jagathsrujan/3d-printable-planetary-gearbox/assets/raw/3D-Model-of-a-two-stage-planetary-gearbox-with-16-to-1-ratio-1024x576.jpg

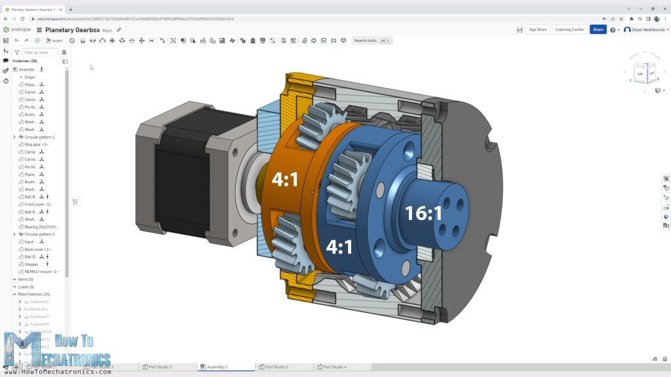
assets/raw/3D-Model-of-a-two-stage-planetary-gearbox-with-16-to-1-ratio-1024x576.jpg
