jagathsrujan/3d-printable-planetary-gearbox/assets/raw/15-teeth-gears-with-3-different-modules-comparison-1024x576.jpg

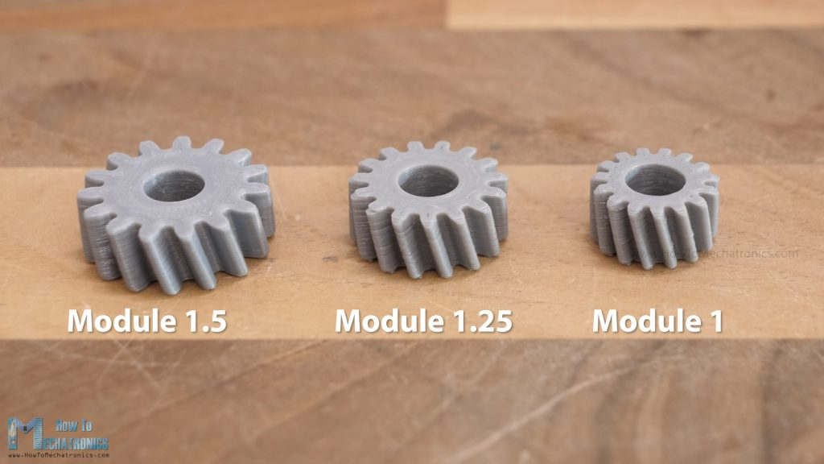
assets/raw/15-teeth-gears-with-3-different-modules-comparison-1024x576.jpg
