jagathsrujan/3d-printable-planetary-gearbox/assets/raw/Co-prime-numbers-for-gears-teeth-1024x576.jpg

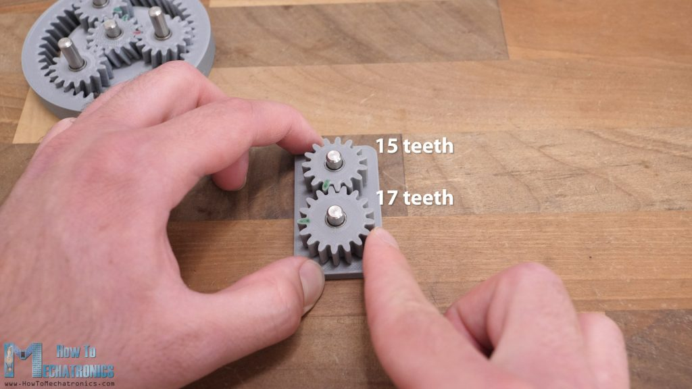
assets/raw/Co-prime-numbers-for-gears-teeth-1024x576.jpg
