jagathsrujan/3d-printable-planetary-gearbox/assets/raw/Design-rule-for-planetary-gearbox-1024x576.jpg

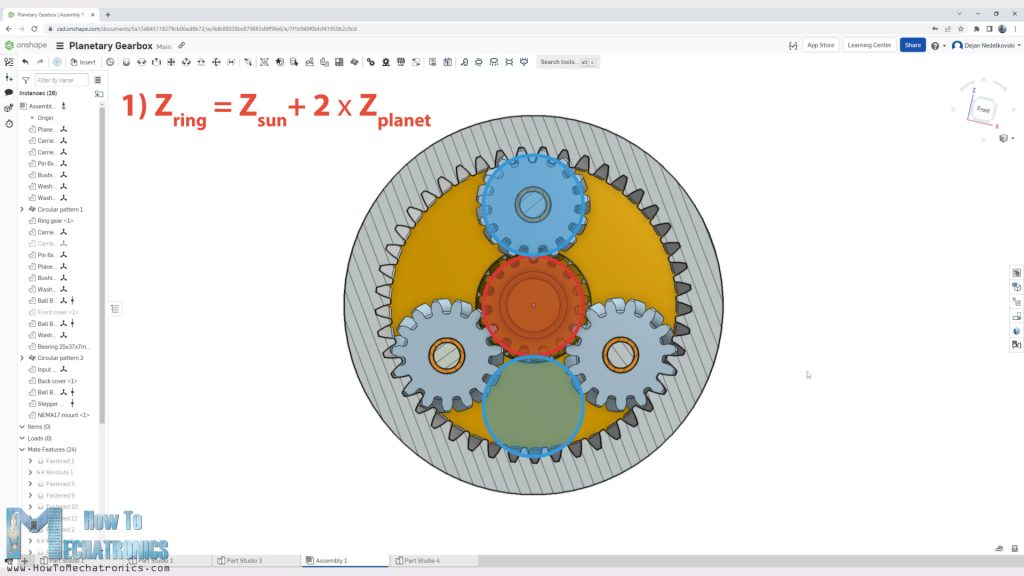
assets/raw/Design-rule-for-planetary-gearbox-1024x576.jpg
