jagathsrujan/3d-printable-planetary-gearbox/assets/raw/Forces-in-planetary-gearboxes-1024x576.jpg

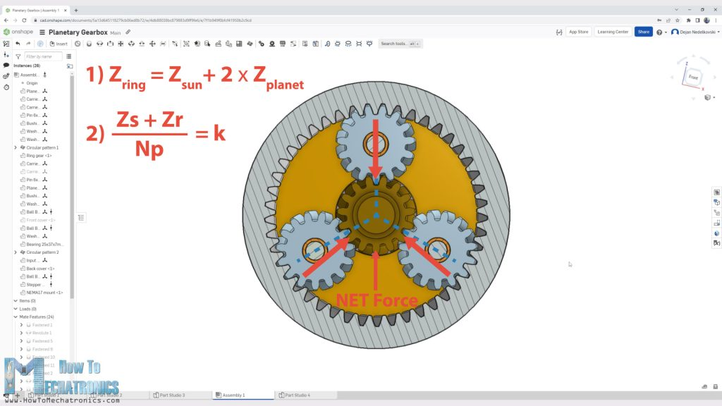
assets/raw/Forces-in-planetary-gearboxes-1024x576.jpg
