jagathsrujan/3d-printable-planetary-gearbox/assets/raw/Generating-a-gear-in-Onshape-with-the-Spur-Gear-FeatureScript-1024x576.jpg

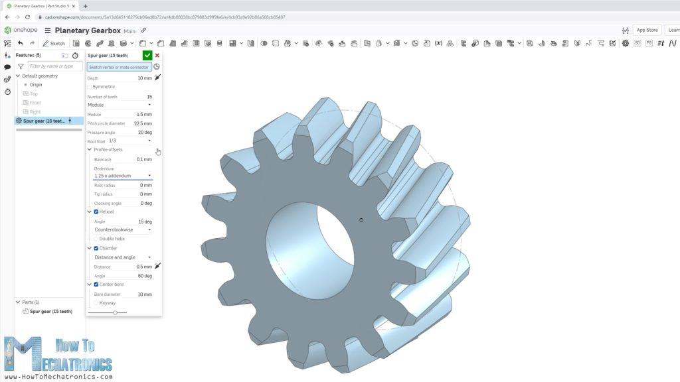
assets/raw/Generating-a-gear-in-Onshape-with-the-Spur-Gear-FeatureScript-1024x576.jpg
