jagathsrujan/3d-printable-planetary-gearbox/assets/raw/Generating-a-gear-with-internal-teeth-ring-gear-in-Onshape-with-the-Boolean-function-1024x576.jpg

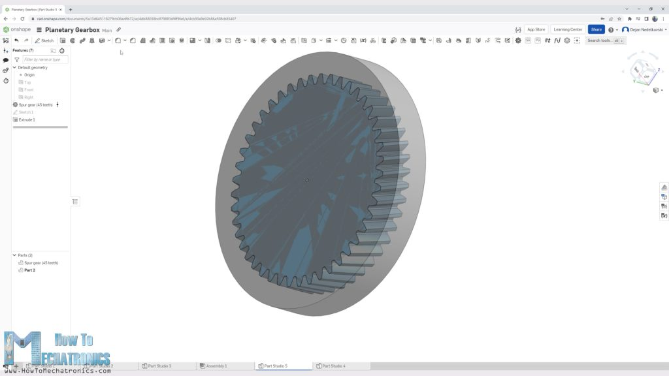
assets/raw/Generating-a-gear-with-internal-teeth-ring-gear-in-Onshape-with-the-Boolean-function-1024x576.jpg
