jagathsrujan/3d-printable-planetary-gearbox/assets/raw/Grub-screw-for-securing-the-motor-shaft-to-the-gearbox-input-shaft-1024x576.jpg

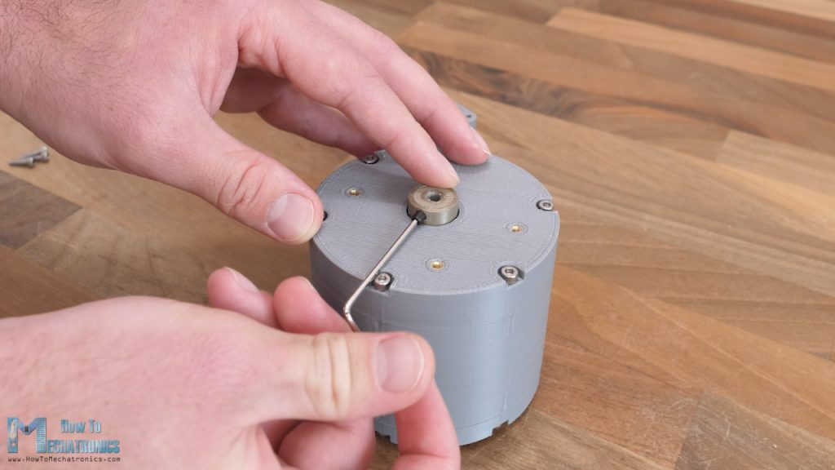
assets/raw/Grub-screw-for-securing-the-motor-shaft-to-the-gearbox-input-shaft-1024x576.jpg
