jagathsrujan/3d-printable-planetary-gearbox/assets/raw/How-a-Planetary-Gear-Set-Works-1024x671.jpg

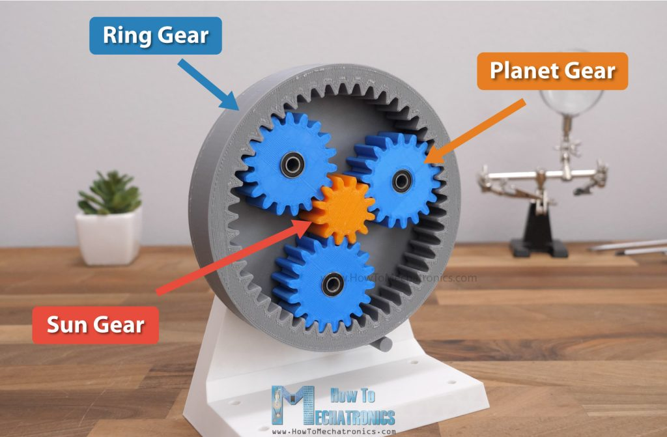
assets/raw/How-a-Planetary-Gear-Set-Works-1024x671.jpg
