jagathsrujan/3d-printable-planetary-gearbox/assets/raw/Inserting-a-threaded-insert-1024x576.jpg

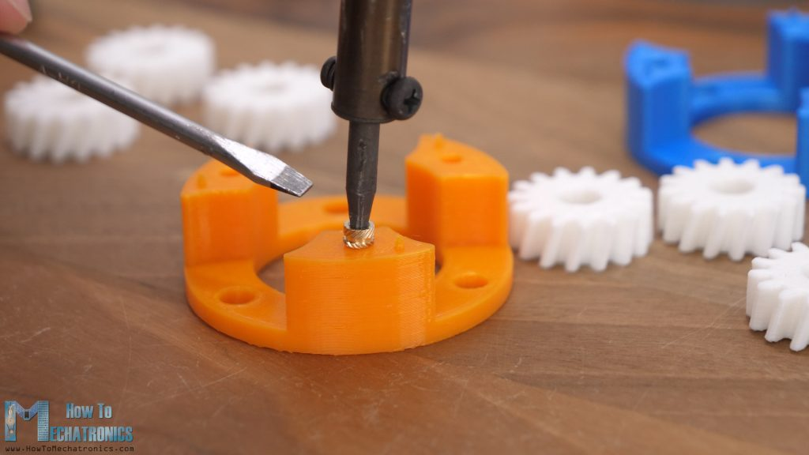
assets/raw/Inserting-a-threaded-insert-1024x576.jpg
