jagathsrujan/3d-printable-planetary-gearbox/assets/raw/Measuring-the-backlash-with-specific-amount-load-applied-to-the-output-shaft-1024x576.jpg

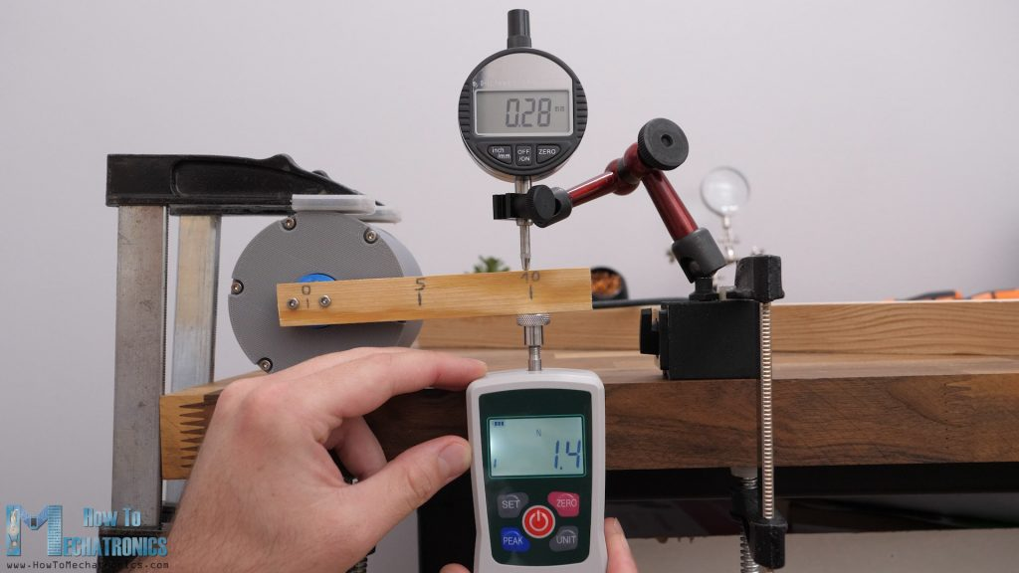
assets/raw/Measuring-the-backlash-with-specific-amount-load-applied-to-the-output-shaft-1024x576.jpg
