jagathsrujan/3d-printable-planetary-gearbox/assets/raw/Modeling-the-ring-gear-as-a-housing-for-the-gearbox-1024x576.jpg

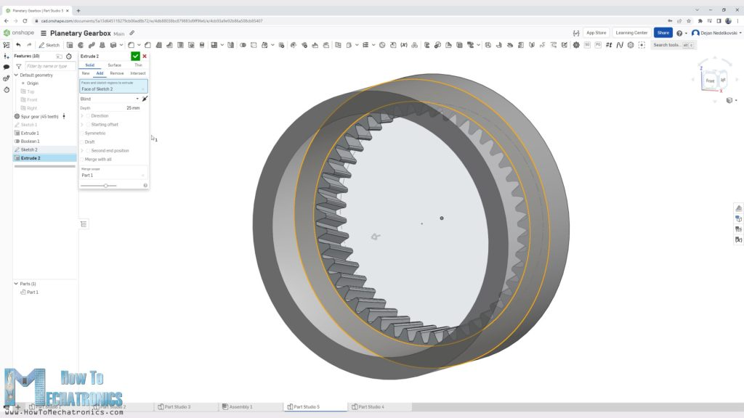
assets/raw/Modeling-the-ring-gear-as-a-housing-for-the-gearbox-1024x576.jpg
