jagathsrujan/3d-printable-planetary-gearbox/assets/raw/Planetary-gear-set-first-stage-1024x576.jpg

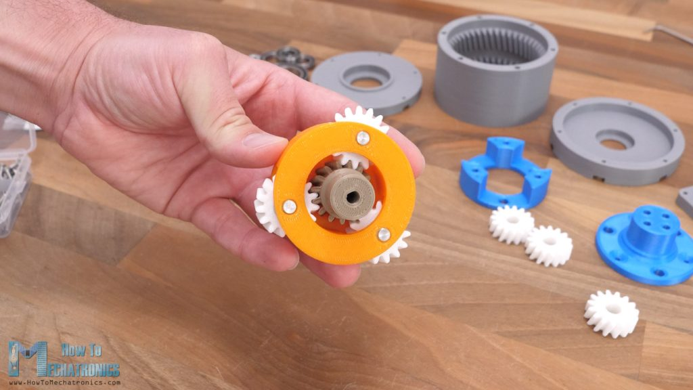
assets/raw/Planetary-gear-set-first-stage-1024x576.jpg
