jagathsrujan/3d-printable-planetary-gearbox/assets/raw/Planetary-gear-set-Sun-gear-input-and-ring-gear-output-example-1024x576.jpg

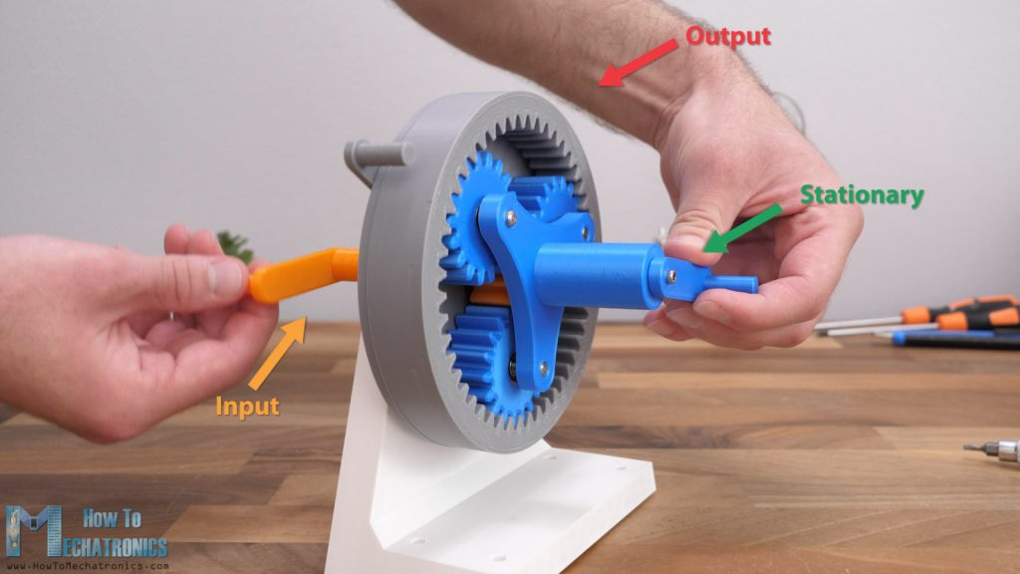
assets/raw/Planetary-gear-set-Sun-gear-input-and-ring-gear-output-example-1024x576.jpg
