jagathsrujan/3d-printable-planetary-gearbox/assets/raw/Planetary-gearbox-Ring-gear-as-input-and-carrier-as-output-1024x576.jpg

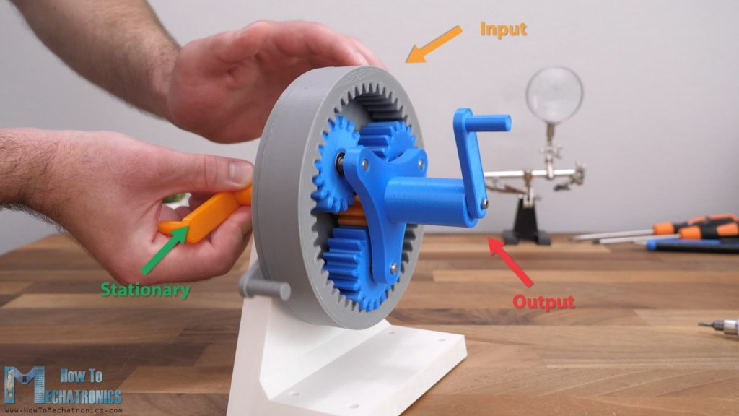
assets/raw/Planetary-gearbox-Ring-gear-as-input-and-carrier-as-output-1024x576.jpg
