jagathsrujan/3d-printable-planetary-gearbox/assets/raw/Planetary-gearbox-working-principle--1024x576.jpg

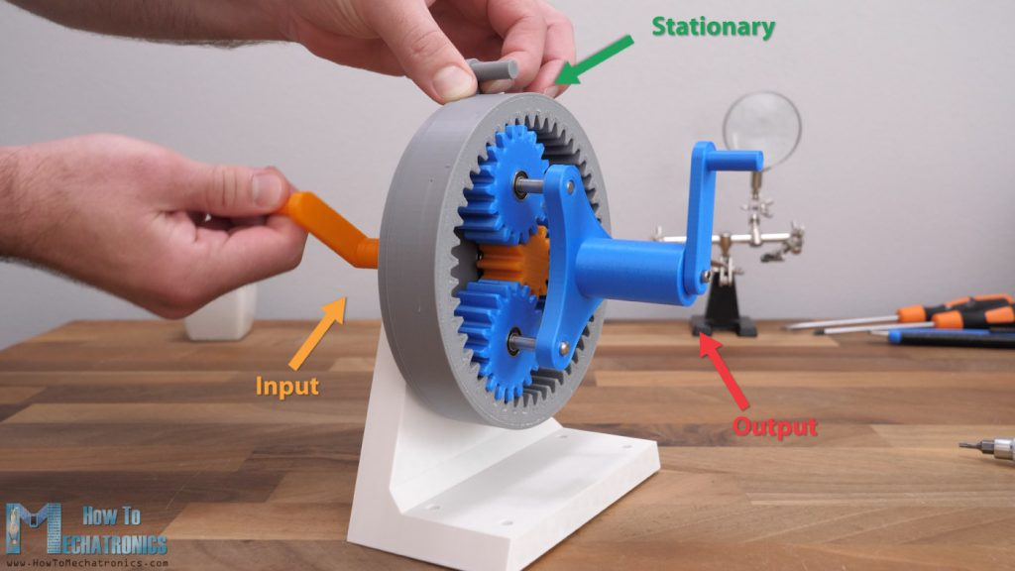
assets/raw/Planetary-gearbox-working-principle--1024x576.jpg
