jagathsrujan/3d-printable-planetary-gearbox/assets/raw/Planetary-gears-in-automatic-transmissions-1024x623.jpg

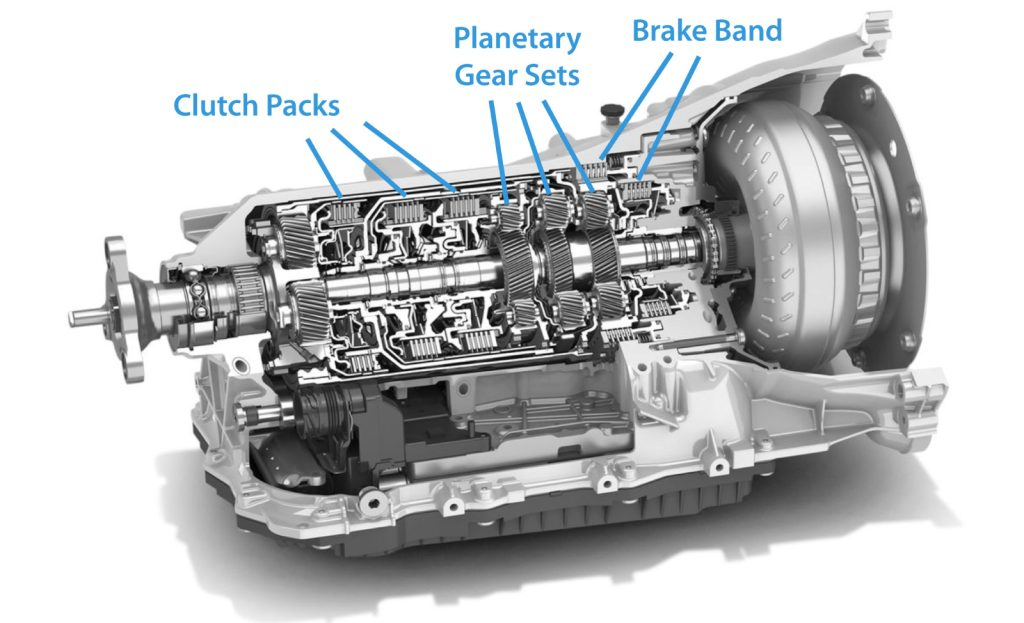
assets/raw/Planetary-gears-in-automatic-transmissions-1024x623.jpg
