jagathsrujan/3d-printable-planetary-gearbox/assets/raw/Planetary-gears-transmission-ratios-formulas-with-example.jpg

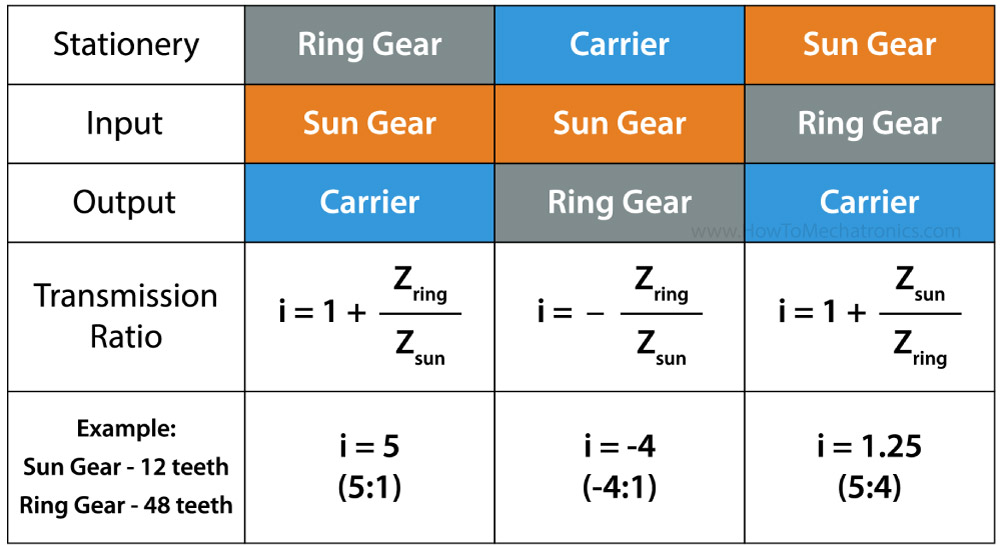
assets/raw/Planetary-gears-transmission-ratios-formulas-with-example.jpg
