jagathsrujan/3d-printable-planetary-gearbox/assets/raw/Sun-gear-and-planet-carrier-design-in-Onshape-1024x576.jpg

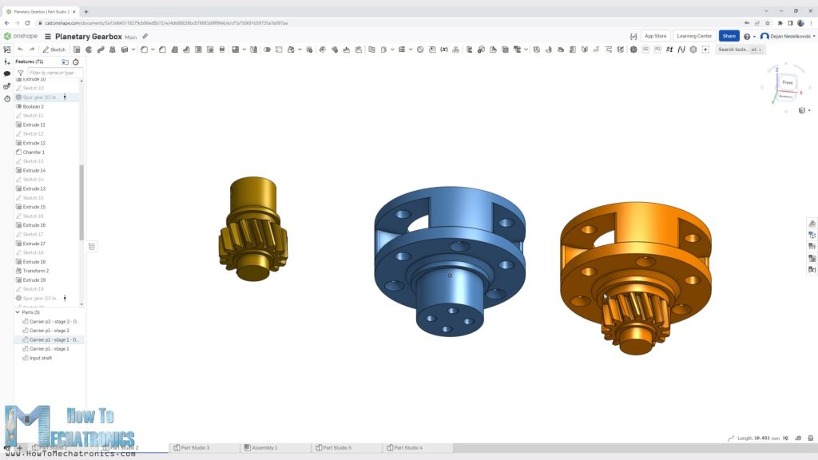
assets/raw/Sun-gear-and-planet-carrier-design-in-Onshape-1024x576.jpg
