jagathsrujan/3d-printable-planetary-gearbox/assets/raw/Two-stage-planetary-gearbox-3D-Model-in-Onshape-1024x558.jpg

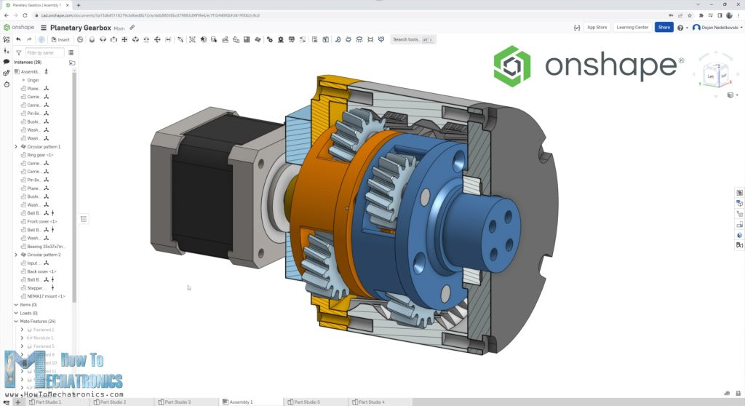
assets/raw/Two-stage-planetary-gearbox-3D-Model-in-Onshape-1024x558.jpg
