jagathsrujan/3d-printable-planetary-gearbox/assets/raw/Two-stage-planetary-gearbox-design-1024x576.jpg

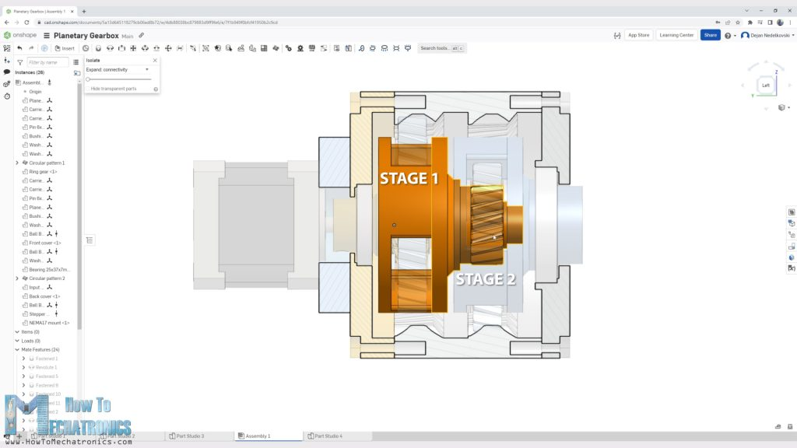
assets/raw/Two-stage-planetary-gearbox-design-1024x576.jpg
