jagathsrujan/3d-printable-planetary-gearbox/assets/raw/Two-stage-planetary-gearbox-with-16-to-1-reduction-ratio-1024x576.jpg

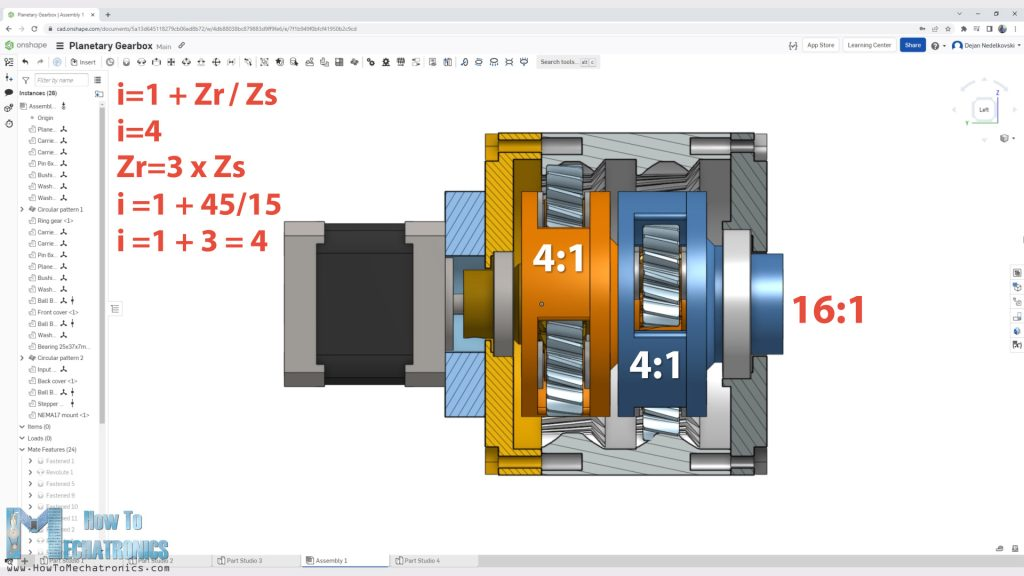
assets/raw/Two-stage-planetary-gearbox-with-16-to-1-reduction-ratio-1024x576.jpg
