jagathsrujan/3d-printable-planetary-gearbox/assets/raw/Uneven-wear-of-the-gears-if-they-have-the-same-number-of-teeth-1024x576.jpg

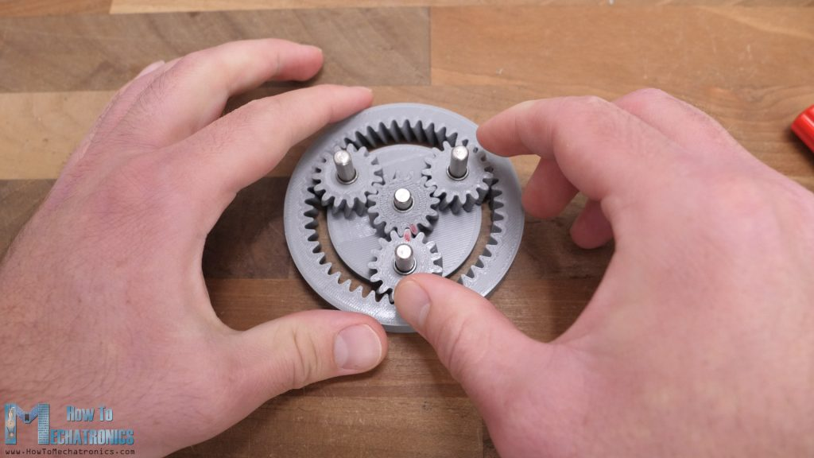
assets/raw/Uneven-wear-of-the-gears-if-they-have-the-same-number-of-teeth-1024x576.jpg
