jagathsrujan/3d-printable-planetary-gearbox/assets/renders/stage-cutaway-alt.png

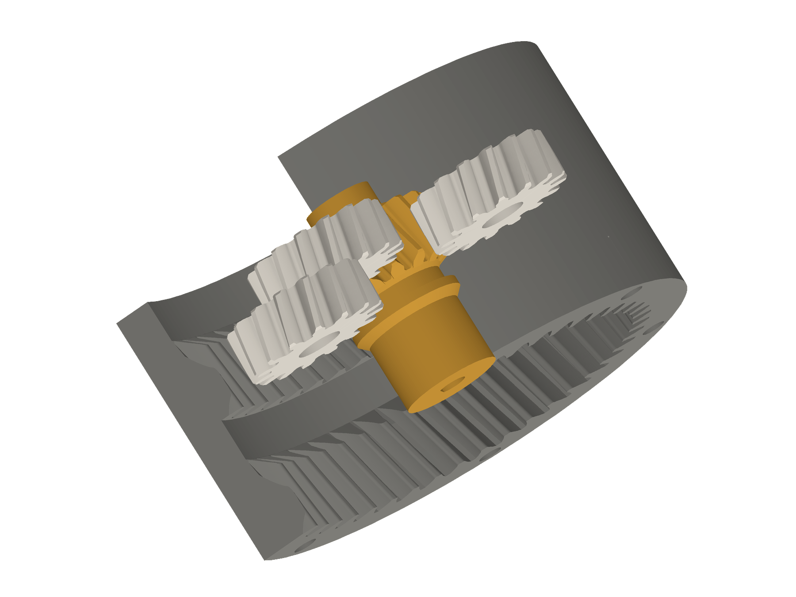
assets/renders/stage-cutaway-alt.png
