jagathsrujan/3d-printable-planetary-gearbox/assets/raw/3D-Printed-parts-for-two-stage-planetary-gearbox-1024x576.jpg

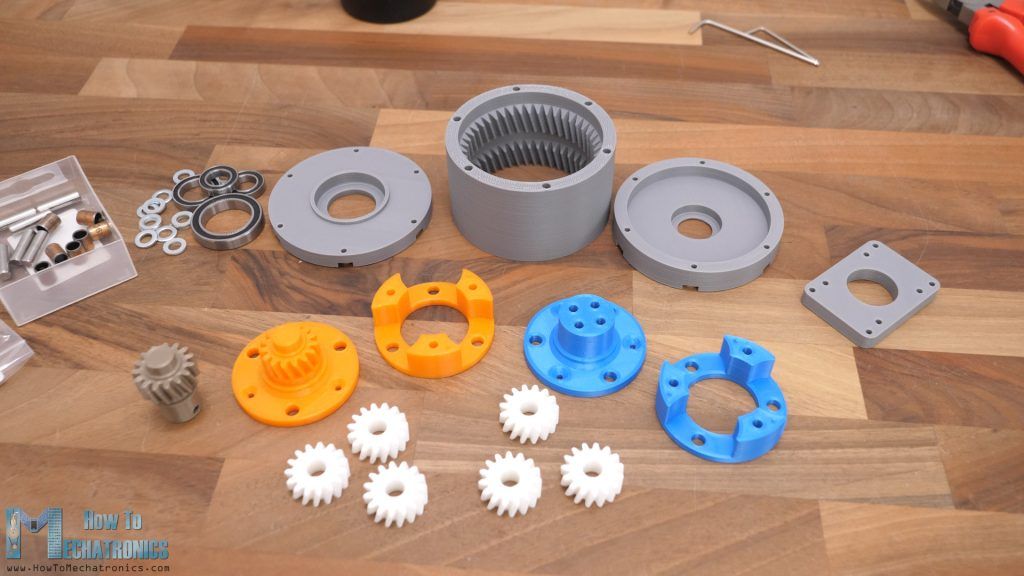
assets/raw/3D-Printed-parts-for-two-stage-planetary-gearbox-1024x576.jpg
