jagathsrujan/3d-printable-planetary-gearbox/assets/raw/Planetary-gearbox-cutaway-section-view-of-the-internal-parts-1024x576.jpg

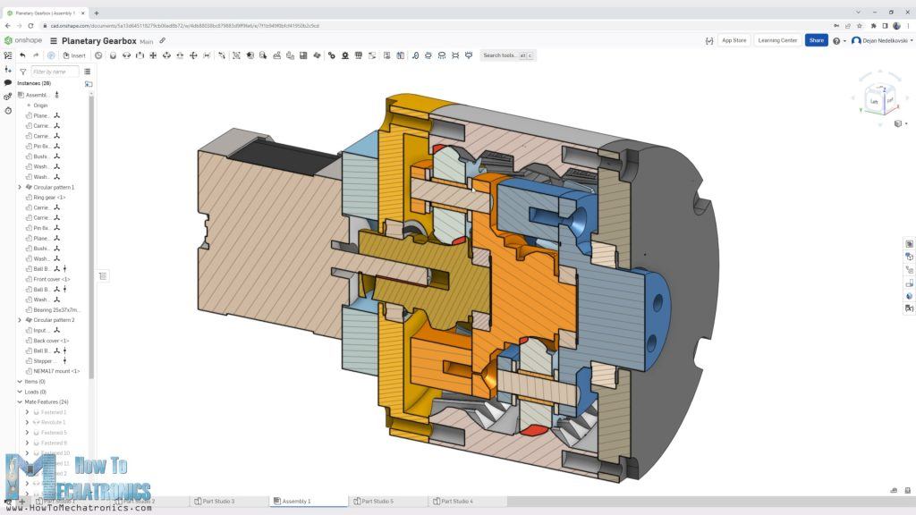
assets/raw/Planetary-gearbox-cutaway-section-view-of-the-internal-parts-1024x576.jpg
