jagathsrujan/3d-printable-planetary-gearbox/assets/raw/Using-the-transform-function-in-Onshape-for-copying-parts-1024x576.jpg

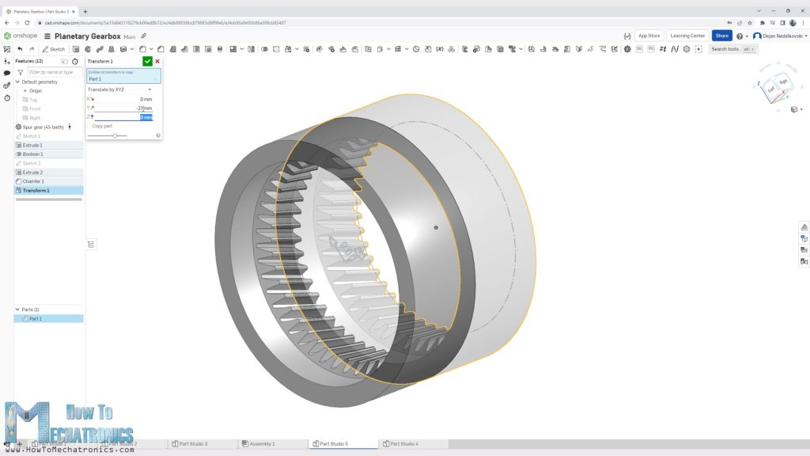
assets/raw/Using-the-transform-function-in-Onshape-for-copying-parts-1024x576.jpg
