jagathsrujan/3d-printable-planetary-gearbox/cad/encoder_mount_assembly.step

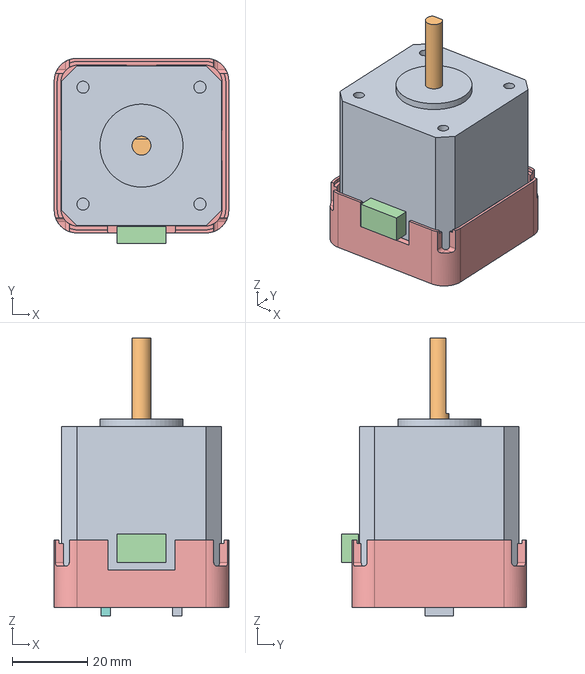
[picture p29: CAD file, 2026-10-26]
cad/encoder_mount_assembly.step
46.3 x 49.1 x 73.7 mm
