jagathsrujan/3d-printable-planetary-gearbox/cad/as5600_module_and_magnet.step

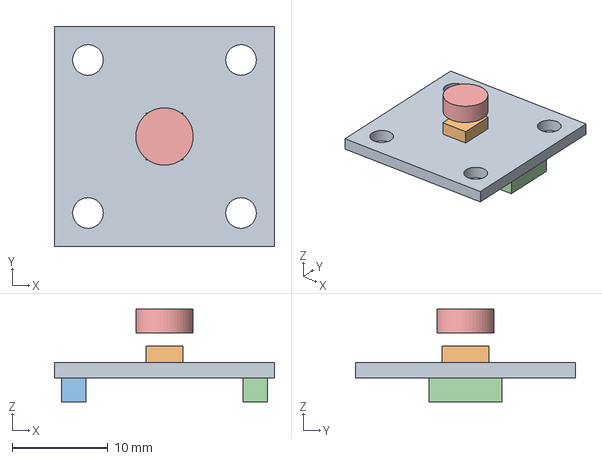
[picture p30: CAD file, 2026-10-26]
cad/as5600_module_and_magnet.step
23.0 x 23.0 x 9.70 mm
