jagathsrujan/3d-printable-planetary-gearbox/Two%20stage%20planetary%20gearbox%20-%20STL%20Files/Carrier p1 - stage 1.stl

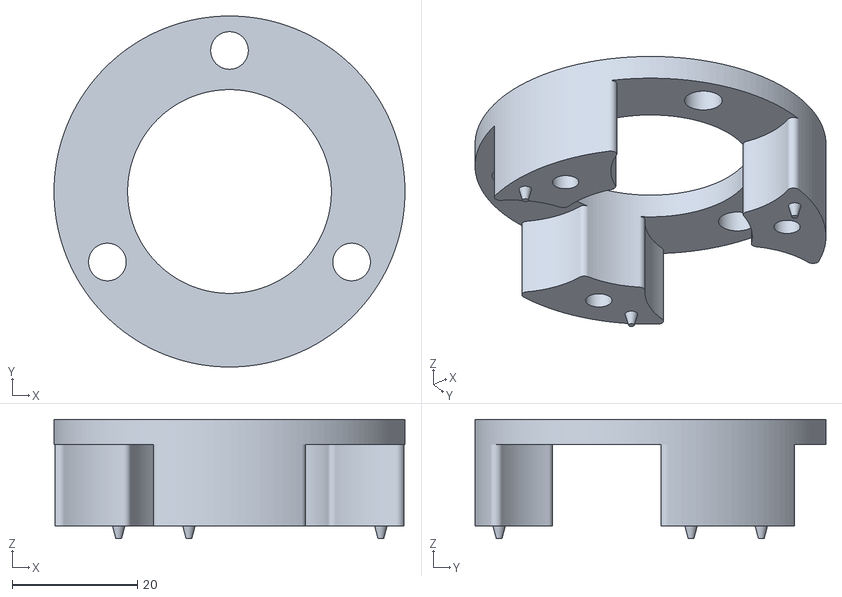
[picture p31: CAD file, 2026-09-22]
Two%20stage%20planetary%20gearbox%20-%20STL%20Files/Carrier p1 - stage 1.stl
56.0 x 56.0 x 19.0
