jagathsrujan/3d-printable-planetary-gearbox/cad/nema17_17he15_1504s.step

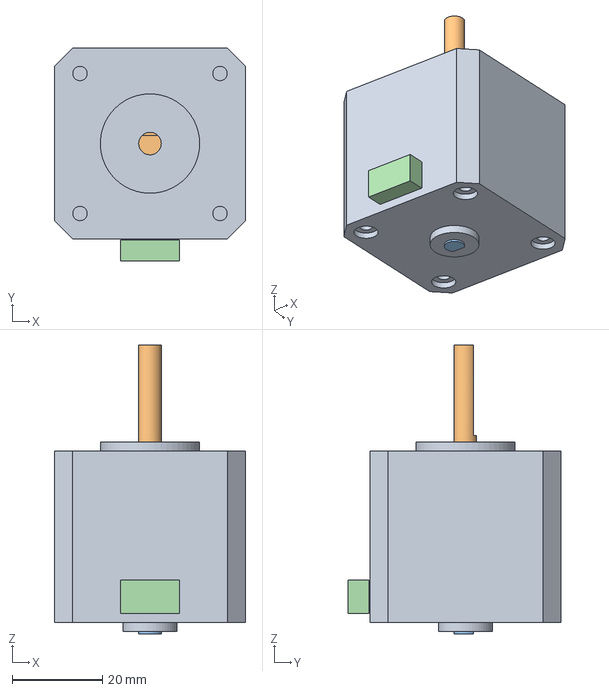
[picture p32: CAD file, 2026-10-26]
cad/nema17_17he15_1504s.step
42.3 x 47.1 x 64.0 mm
