jagathsrujan/3d-printable-planetary-gearbox/Two%20stage%20planetary%20gearbox%20-%20STL%20Files/Ring gear.stl

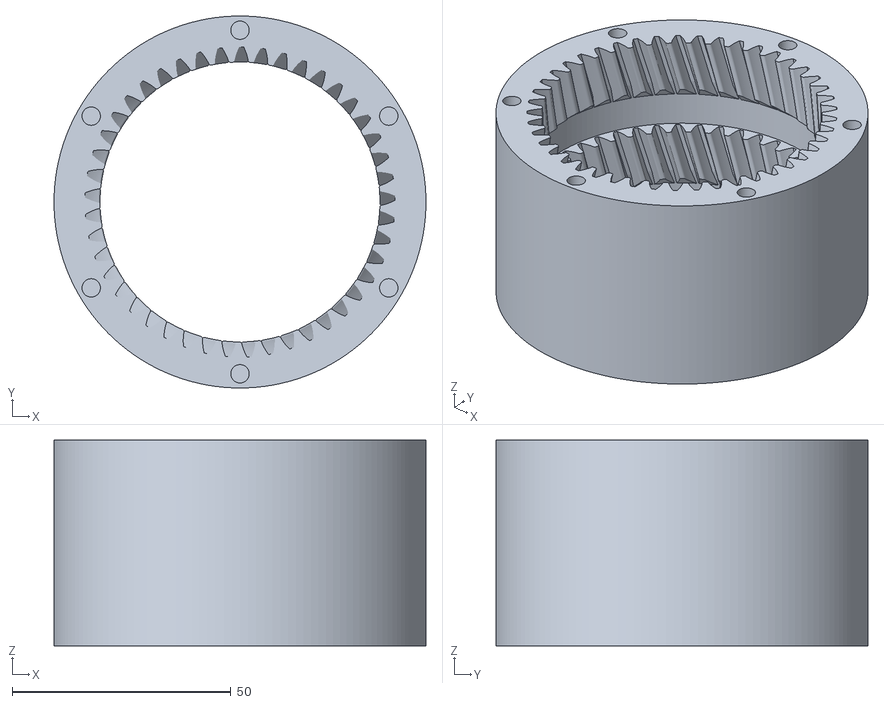
[picture p33: CAD file, 2026-09-22]
Two%20stage%20planetary%20gearbox%20-%20STL%20Files/Ring gear.stl
85.0 x 85.0 x 47.0
