jagathsrujan/3d-printable-planetary-gearbox/Two%20stage%20planetary%20gearbox%20-%20STL%20Files/Back cover r1.stl

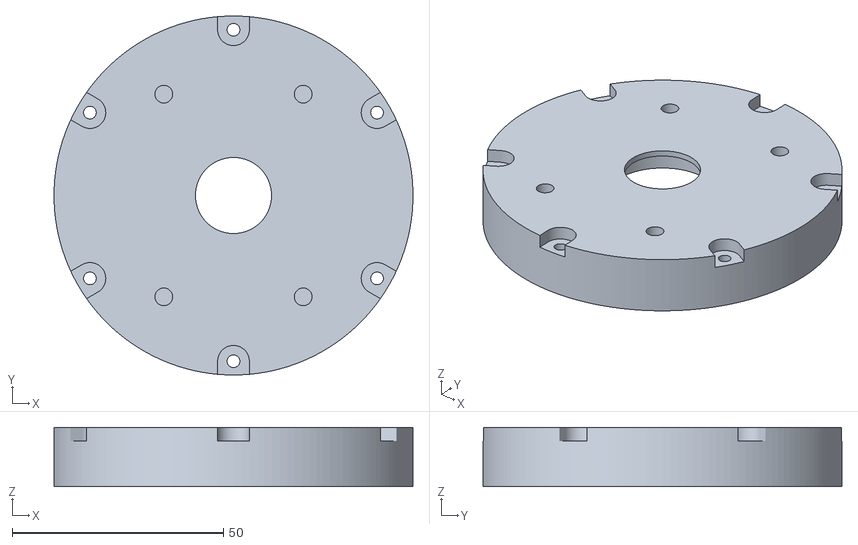
[picture p34: CAD file, 2026-09-22]
Two%20stage%20planetary%20gearbox%20-%20STL%20Files/Back cover r1.stl
85.0 x 85.0 x 14.0
