jagathsrujan/3d-printable-planetary-gearbox/cad/encoder_mount_holder.step

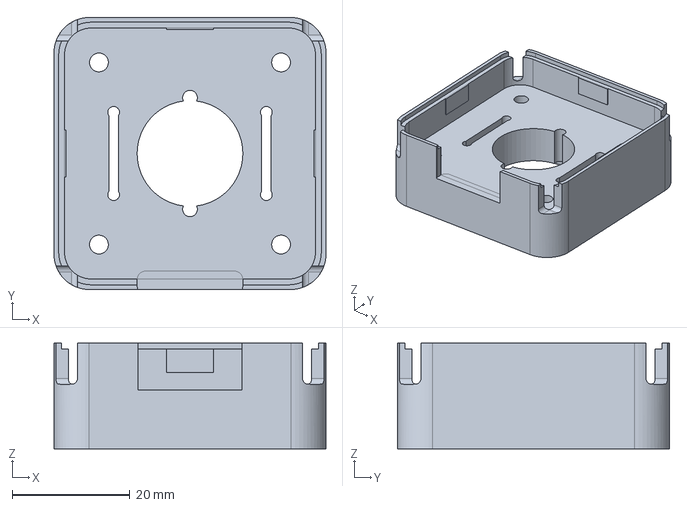
[picture p35: CAD file, 2026-10-26]
cad/encoder_mount_holder.step
46.3 x 46.3 x 18.0 mm
