jagathsrujan/3d-printable-planetary-gearbox/Two%20stage%20planetary%20gearbox%20-%20STL%20Files/Input shaft r1.stl

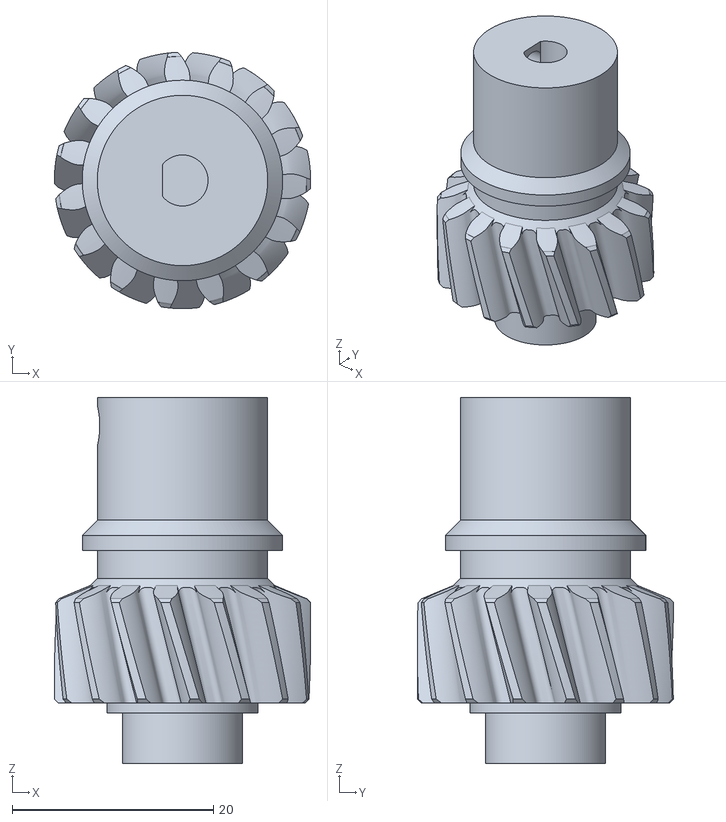
[picture p37: CAD file, 2026-09-22]
Two%20stage%20planetary%20gearbox%20-%20STL%20Files/Input shaft r1.stl
25.5 x 25.5 x 36.4
