jagathsrujan/3d-printable-planetary-gearbox/Two%20stage%20planetary%20gearbox%20-%20STL%20Files/Front cover.stl

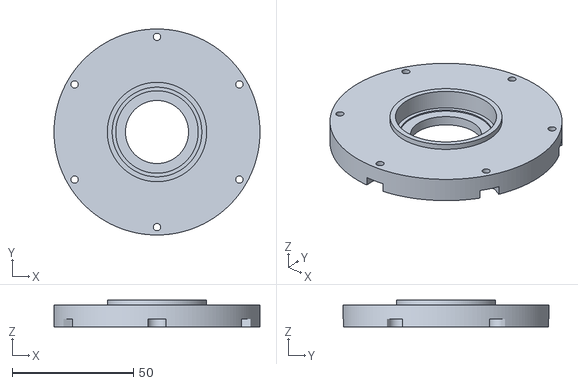
[picture p38: CAD file, 2026-09-22]
Two%20stage%20planetary%20gearbox%20-%20STL%20Files/Front cover.stl
85.0 x 85.0 x 11.0
