jagathsrujan/3d-printable-planetary-gearbox/Two%20stage%20planetary%20gearbox%20-%20STL%20Files/NEMA17 mount r2.stl

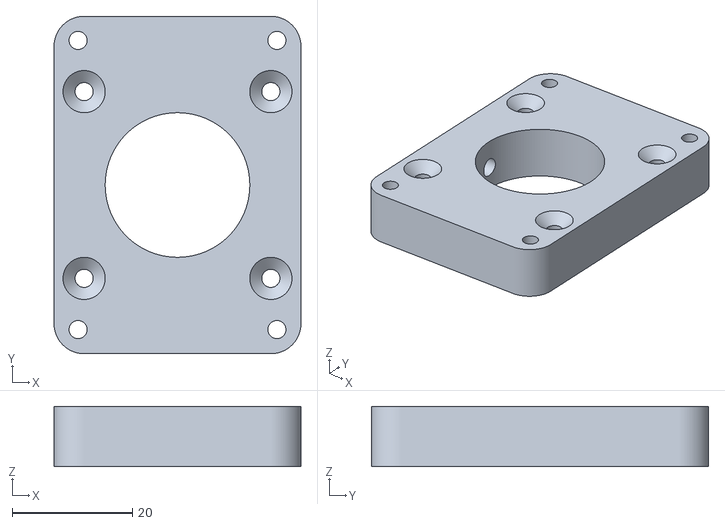
[picture p39: CAD file, 2026-09-22]
Two%20stage%20planetary%20gearbox%20-%20STL%20Files/NEMA17 mount r2.stl
41.0 x 56.0 x 10.0
