jagathsrujan/3d-printable-planetary-gearbox/Two%20stage%20planetary%20gearbox%20-%20STL%20Files/Carrier p2 - stage 2 - Output.stl

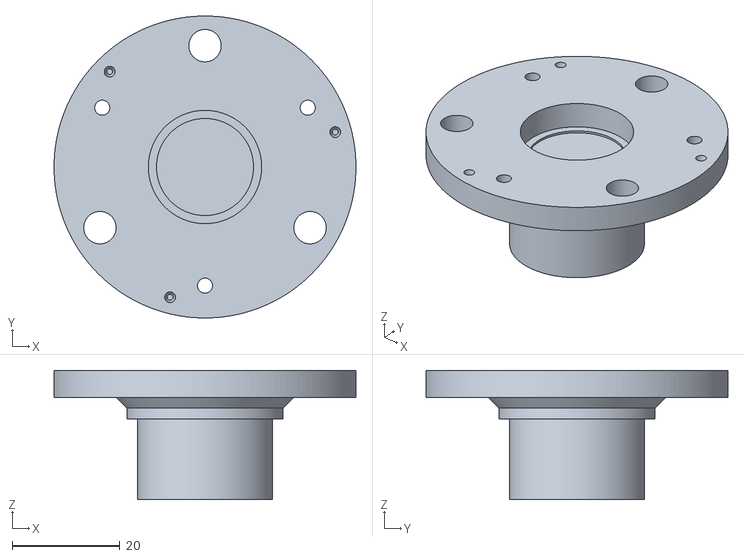
[picture p40: CAD file, 2026-09-22]
Two%20stage%20planetary%20gearbox%20-%20STL%20Files/Carrier p2 - stage 2 - Output.stl
56.0 x 56.0 x 24.0
