jagathsrujan/3d-printable-planetary-gearbox/Two%20stage%20planetary%20gearbox%20-%20STL%20Files/Planet gear - 15 tooth helical.stl

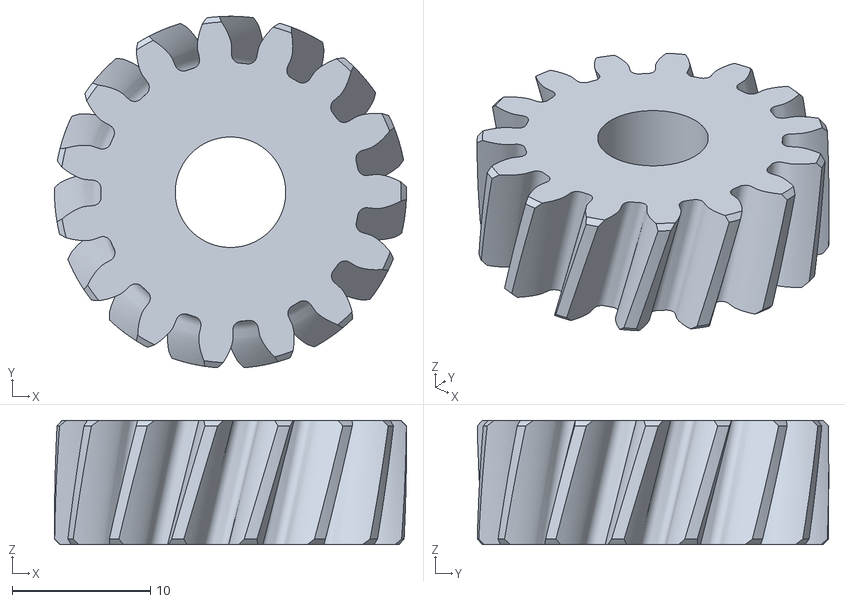
[picture p41: CAD file, 2026-09-22]
Two%20stage%20planetary%20gearbox%20-%20STL%20Files/Planet gear - 15 tooth helical.stl
25.5 x 25.5 x 9.00
