jagathsrujan/3d-printable-planetary-gearbox/Two%20stage%20planetary%20gearbox%20-%20STL%20Files/Carrier p1 - stage 1 - Output.stl

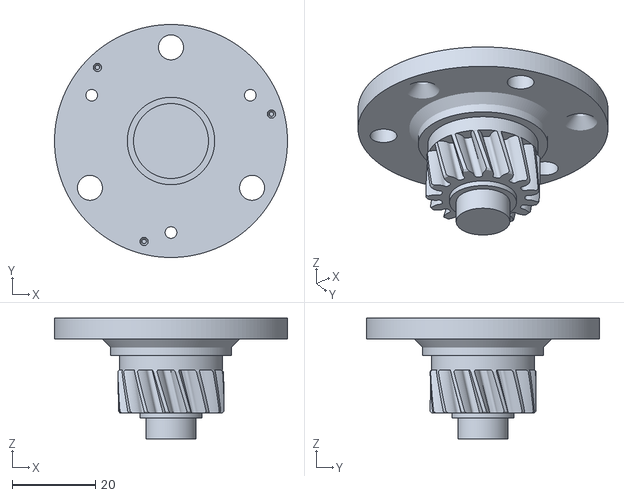
[picture p42: CAD file, 2026-09-22]
Two%20stage%20planetary%20gearbox%20-%20STL%20Files/Carrier p1 - stage 1 - Output.stl
56.0 x 56.0 x 29.0
