jagathsrujan/3d-printable-planetary-gearbox/Two%20stage%20planetary%20gearbox%20-%20STL%20Files/CUTOUT - Ring gear.stl

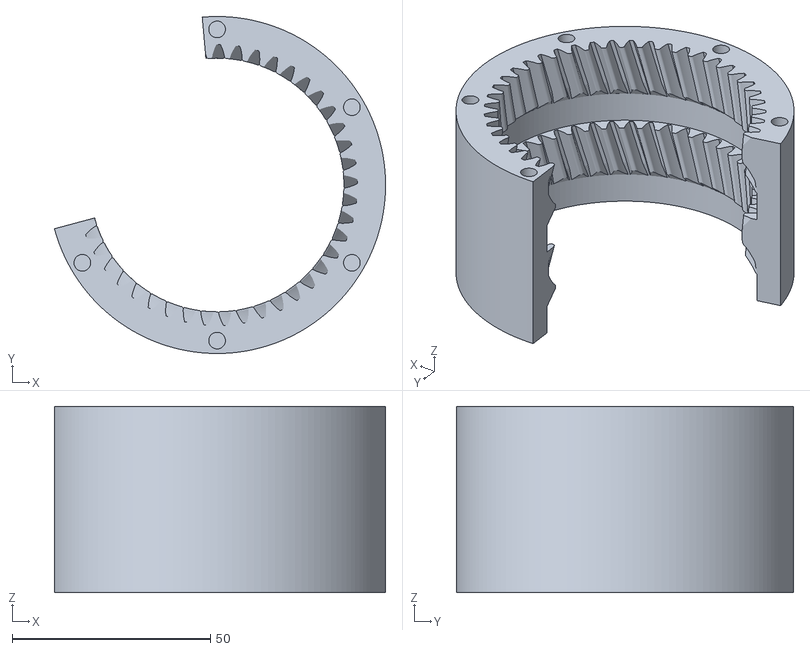
[picture p44: CAD file, 2026-09-22]
Two%20stage%20planetary%20gearbox%20-%20STL%20Files/CUTOUT - Ring gear.stl
83.5 x 85.0 x 47.0
