jagathsrujan/3d-printable-planetary-gearbox/(list of files, cad)

Other CAD files:
cad/encoder_mount.FCStd
Two%20stage%20planetary%20gearbox%20-%20STL%20Files/Carrier p1 - stage 2.stl
cad/encoder_mount_holder.stl
