jagathsrujan/3d-printable-planetary-gearbox/assets/raw/3D-Printed-Planetary-Gear-Set-Model-How-It-Works-1024x671.jpg

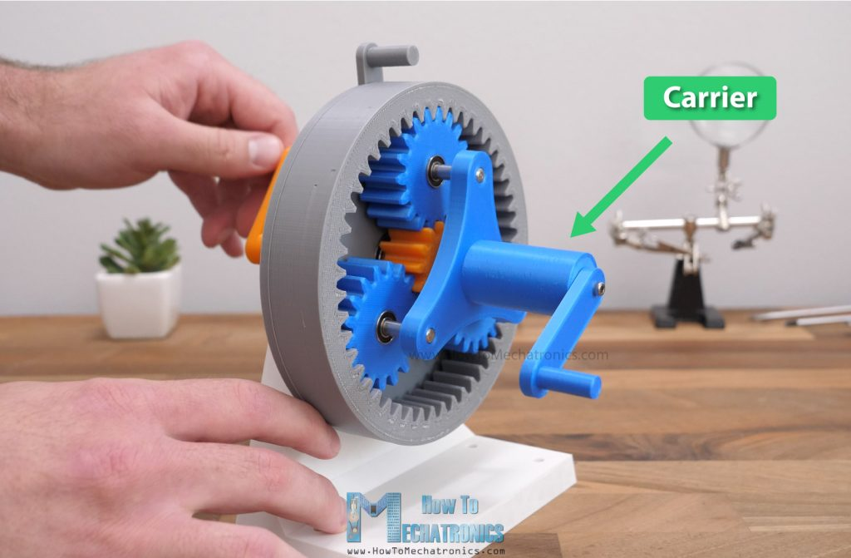
assets/raw/3D-Printed-Planetary-Gear-Set-Model-How-It-Works-1024x671.jpg
