jagathsrujan/3d-printable-planetary-gearbox/assets/raw/3D-Printed-Planetary-Gearbox-Cutaway-How-It-Works-1024x576.jpg

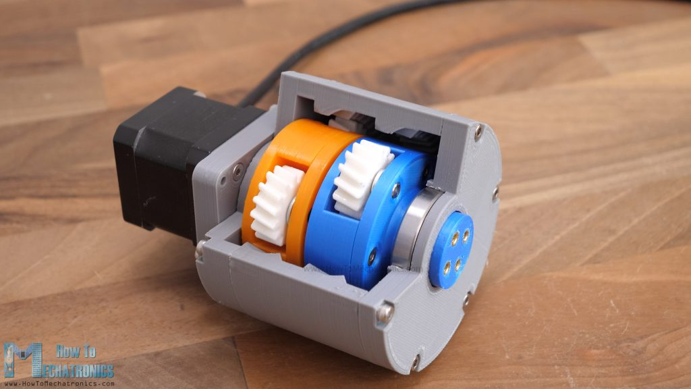
assets/raw/3D-Printed-Planetary-Gearbox-Cutaway-How-It-Works-1024x576.jpg
