jagathsrujan/3d-printable-planetary-gearbox/assets/raw/3D-Printed-Planetary-Gearbox-Cutaway-Whats-inside-a-gearbox-1024x771.jpg

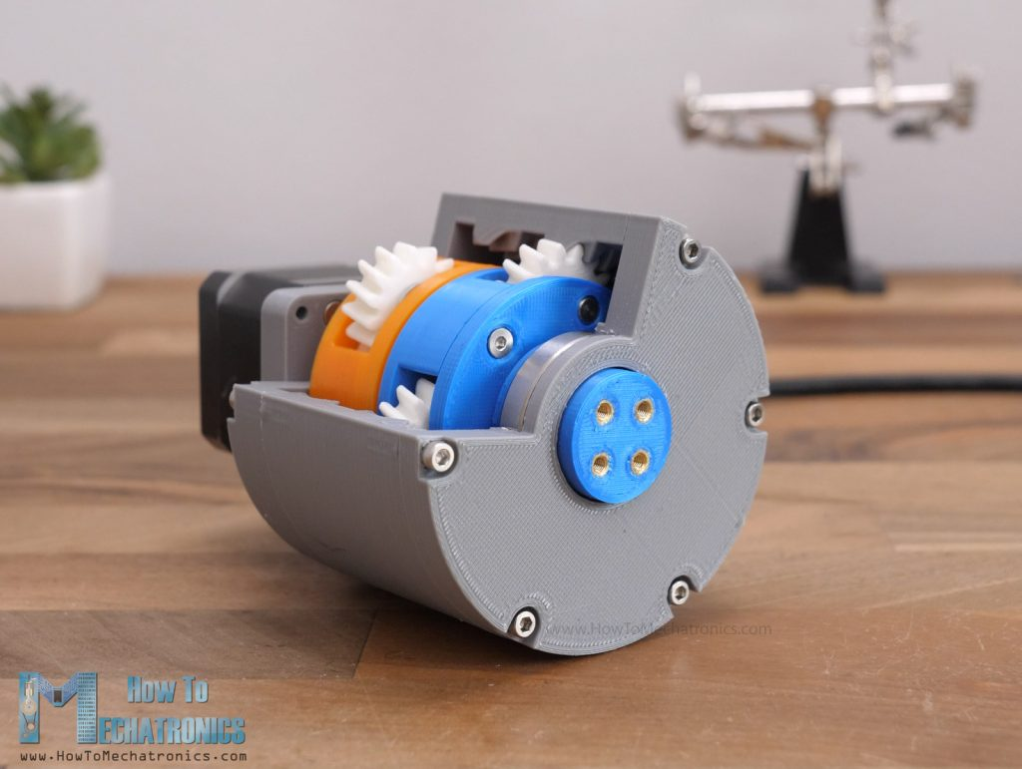
assets/raw/3D-Printed-Planetary-Gearbox-Cutaway-Whats-inside-a-gearbox-1024x771.jpg
