jagathsrujan/3d-printable-planetary-gearbox/assets/raw/3D-printed-ring-gear-housing-for-planetary-gearbox-1024x576.jpg

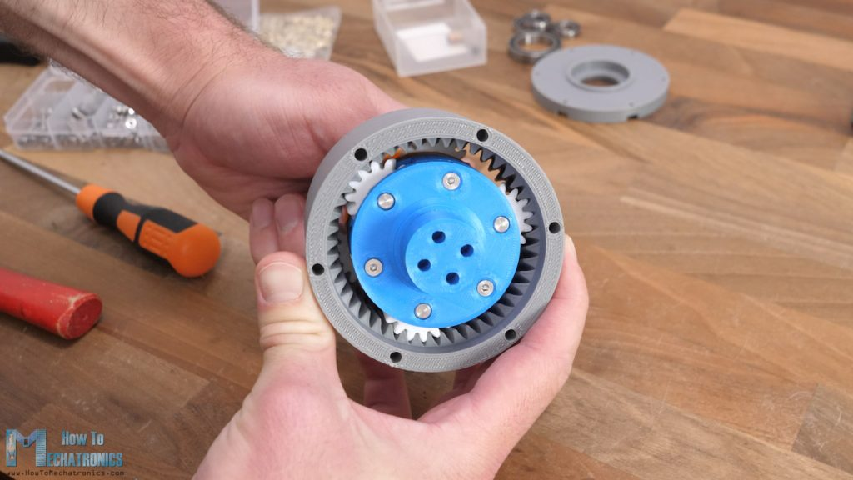
assets/raw/3D-printed-ring-gear-housing-for-planetary-gearbox-1024x576.jpg
