jagathsrujan/3d-printable-planetary-gearbox/assets/raw/3D-printed-two-stage-planetary-gearbox-assembly-1024x576.jpg

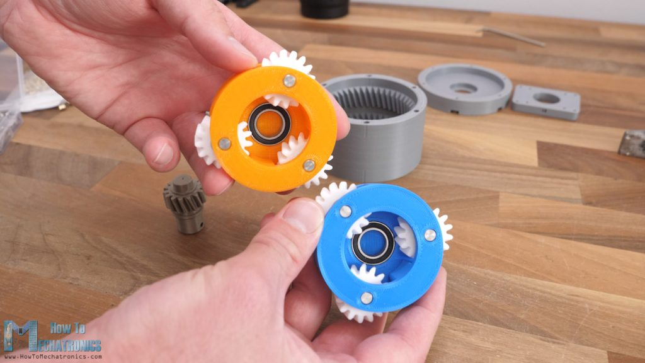
assets/raw/3D-printed-two-stage-planetary-gearbox-assembly-1024x576.jpg
