jagathsrujan/3d-printable-planetary-gearbox/assets/raw/3D-printed-two-stage-planetary-gearbox-for-NEMA-17-stepper-motor-1024x576.jpg

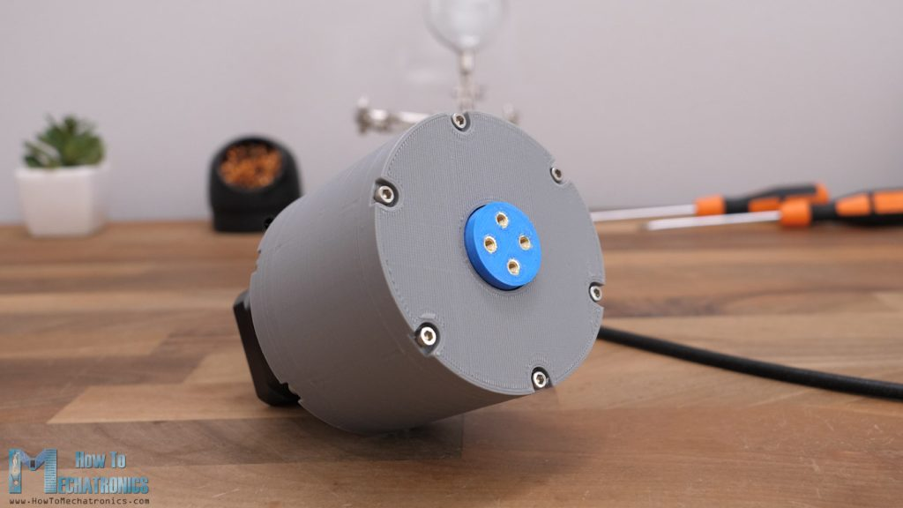
assets/raw/3D-printed-two-stage-planetary-gearbox-for-NEMA-17-stepper-motor-1024x576.jpg
