jagathsrujan/3d-printable-planetary-gearbox/assets/raw/Adjusting-the-Horizontal-Expansion-settings-for-getting-dimensionally-accurate-prints-1024x576.jpg

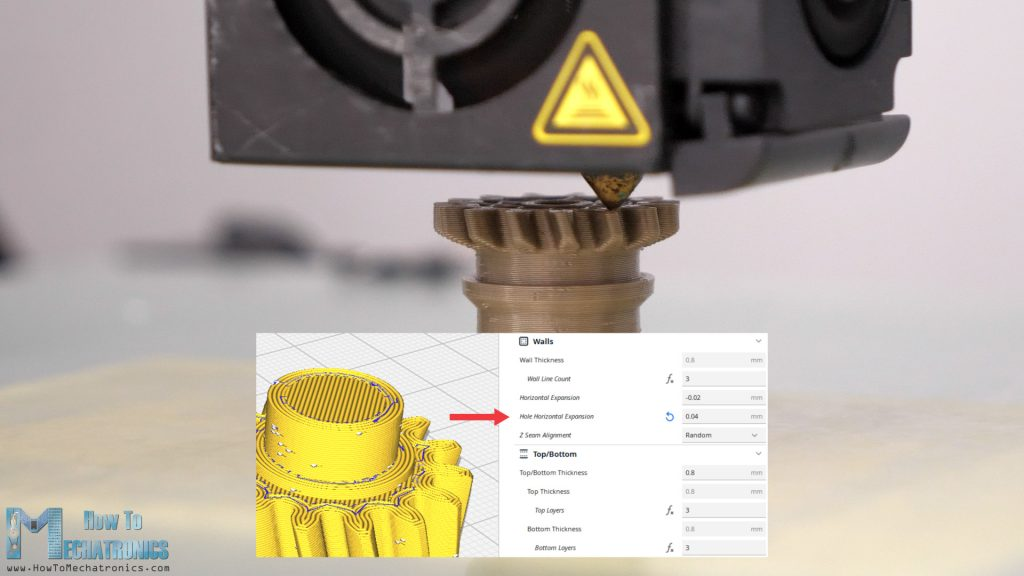
assets/raw/Adjusting-the-Horizontal-Expansion-settings-for-getting-dimensionally-accurate-prints-1024x576.jpg
