jagathsrujan/3d-printable-planetary-gearbox/assets/raw/Assembling-the-gearbox-back-plate-with-M3-bolts-1024x576.jpg

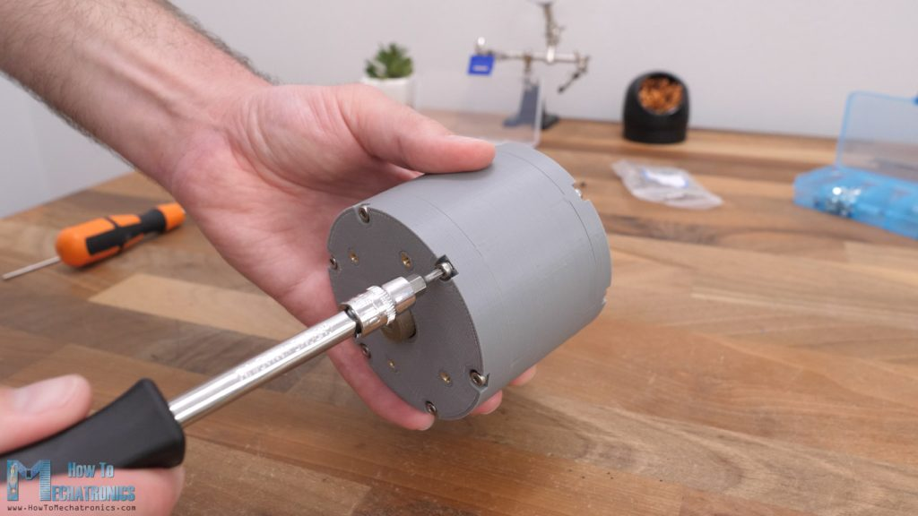
assets/raw/Assembling-the-gearbox-back-plate-with-M3-bolts-1024x576.jpg
