jagathsrujan/3d-printable-planetary-gearbox/assets/raw/Assembling-the-planet-carrier-1024x576.jpg

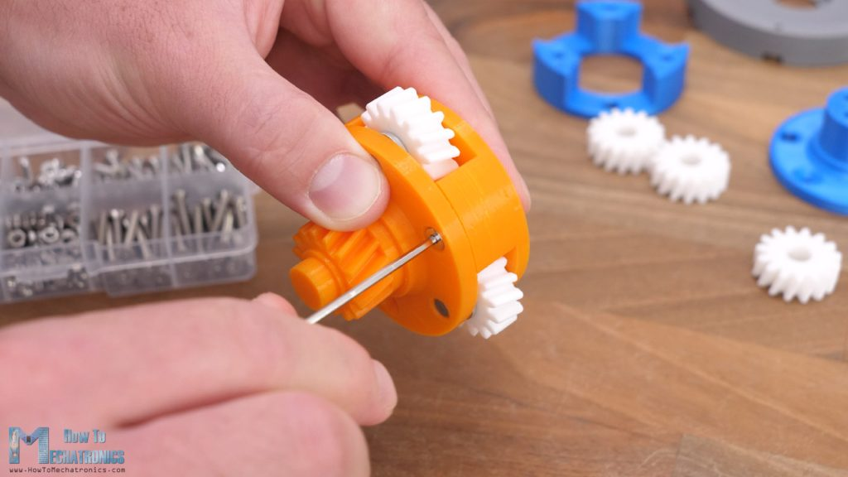
assets/raw/Assembling-the-planet-carrier-1024x576.jpg
