jagathsrujan/3d-printable-planetary-gearbox/assets/raw/Assembling-the-planetary-gearbox-front-cover-plate--1024x576.jpg

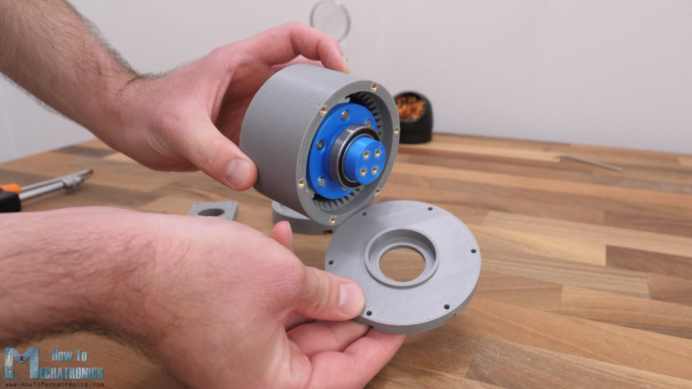
assets/raw/Assembling-the-planetary-gearbox-front-cover-plate--1024x576.jpg
