jagathsrujan/3d-printable-planetary-gearbox/assets/raw/Backlash-testing-on-3D-printed-planetary-gearbox-impressive-result-1024x576.jpg

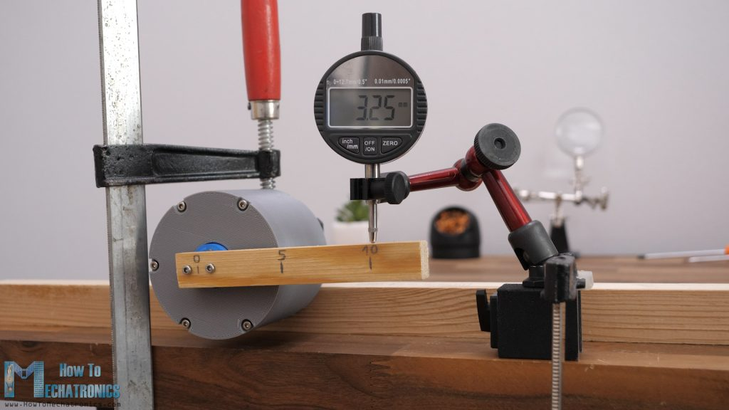
assets/raw/Backlash-testing-on-3D-printed-planetary-gearbox-impressive-result-1024x576.jpg
