jagathsrujan/3d-printable-planetary-gearbox/assets/raw/How-to-calculate-arcminutes-for-expressing-gearbox-backlash-1024x576.jpg

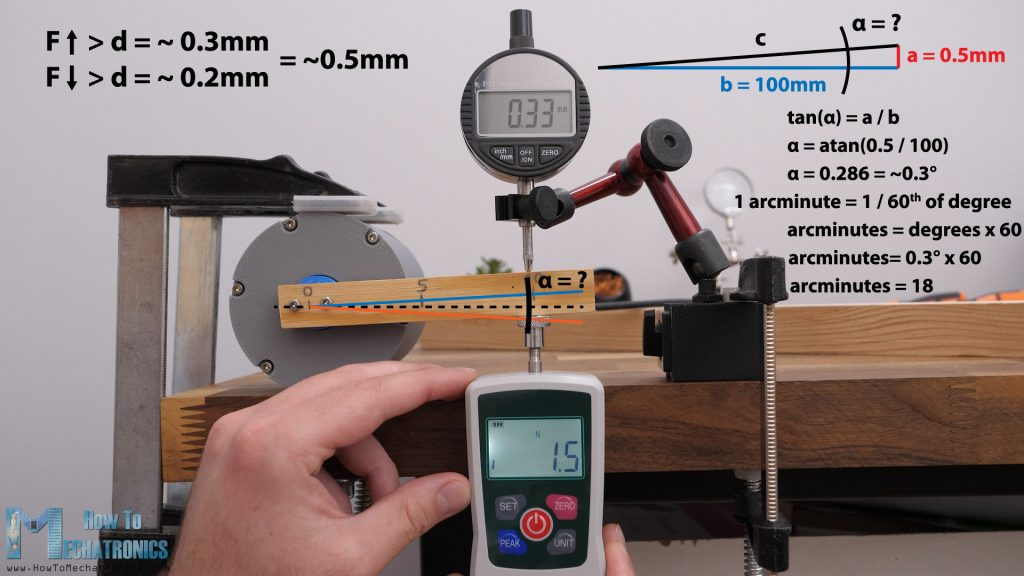
assets/raw/How-to-calculate-arcminutes-for-expressing-gearbox-backlash-1024x576.jpg
