jagathsrujan/3d-printable-planetary-gearbox/assets/raw/Inserting-the-sun-gears-into-the-carrier-assembly-1024x576.jpg

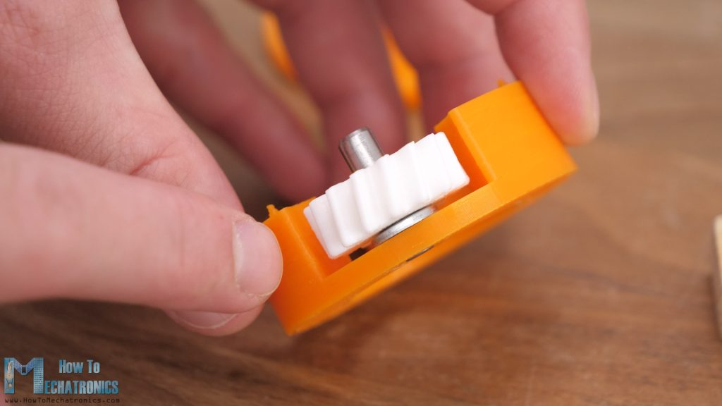
assets/raw/Inserting-the-sun-gears-into-the-carrier-assembly-1024x576.jpg
