jagathsrujan/3d-printable-planetary-gearbox/assets/raw/Lubricating-3D-printed-gears-for-smoother-operation-1024x576.jpg

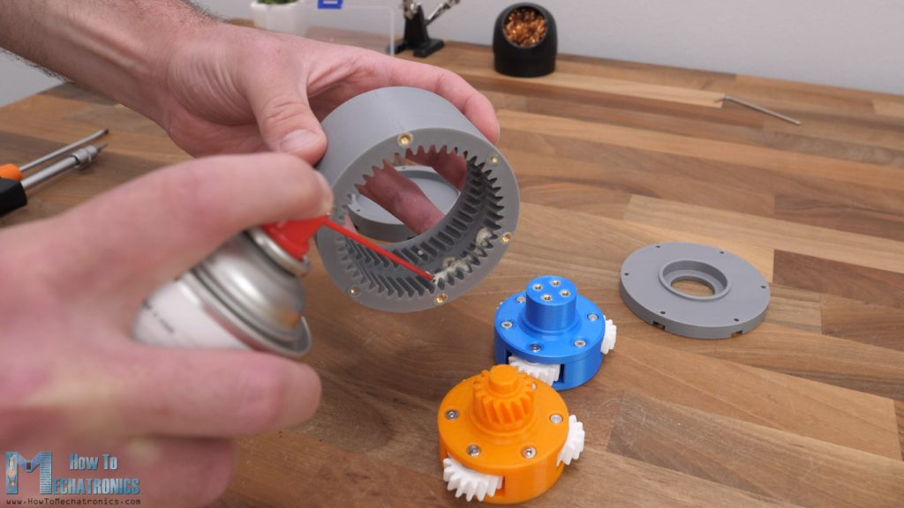
assets/raw/Lubricating-3D-printed-gears-for-smoother-operation-1024x576.jpg
