jagathsrujan/3d-printable-planetary-gearbox/assets/raw/Mounting-a-NEMA-17-stepper-motor-to-the-3D-printed-planetary-gearbox-1024x576.jpg

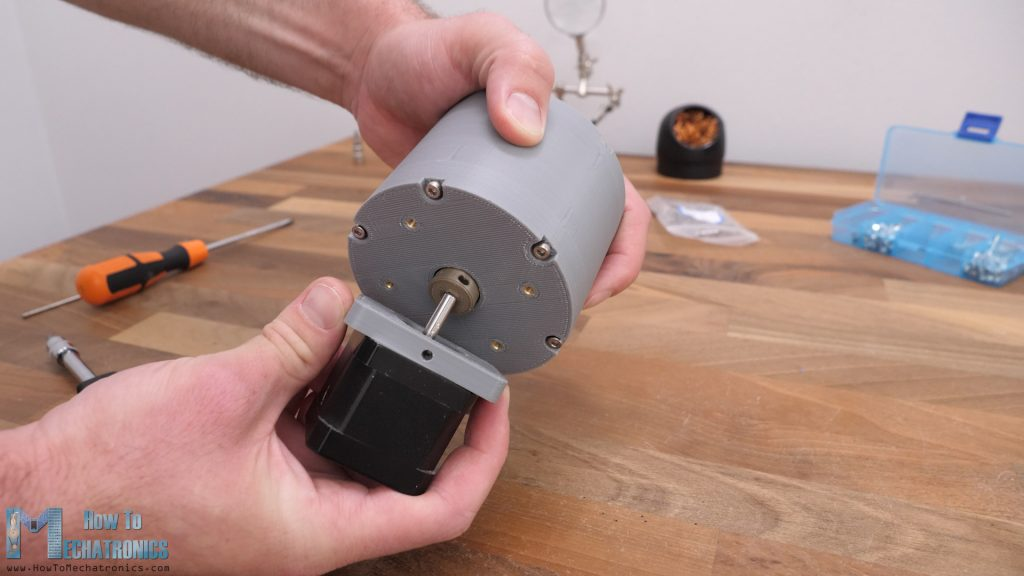
assets/raw/Mounting-a-NEMA-17-stepper-motor-to-the-3D-printed-planetary-gearbox-1024x576.jpg
