jagathsrujan/3d-printable-planetary-gearbox/assets/raw/Torque-test-of-a-3D-printed-planetary-gearbox-measuring-with-force-meter-1024x576.jpg

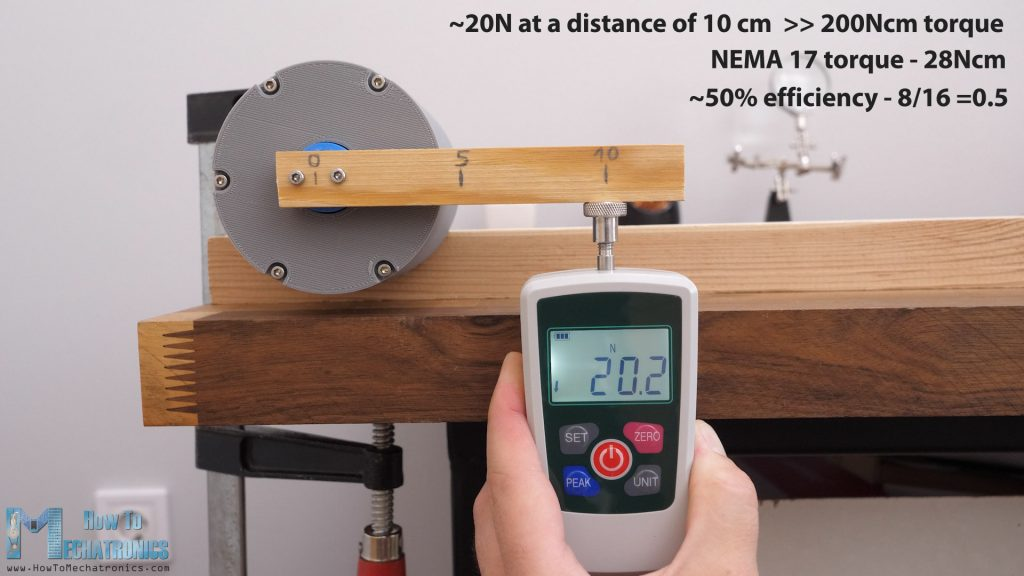
assets/raw/Torque-test-of-a-3D-printed-planetary-gearbox-measuring-with-force-meter-1024x576.jpg
