jagathsrujan/3d-printable-planetary-gearbox/assets/raw/Backlash-test-measuring-output-shaft-displacement-1024x576.jpg

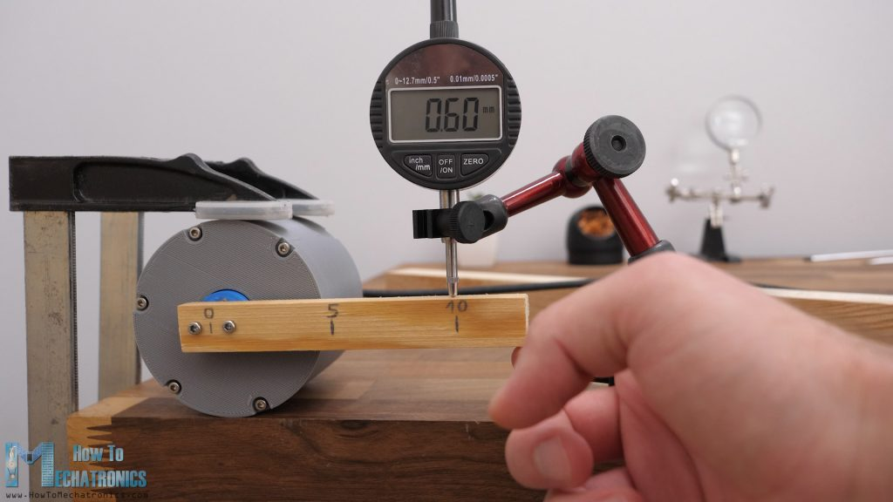
assets/raw/Backlash-test-measuring-output-shaft-displacement-1024x576.jpg
