jagathsrujan/3d-printable-planetary-gearbox/assets/raw/Backlash-testing-with-applied-force-1024x576.jpg

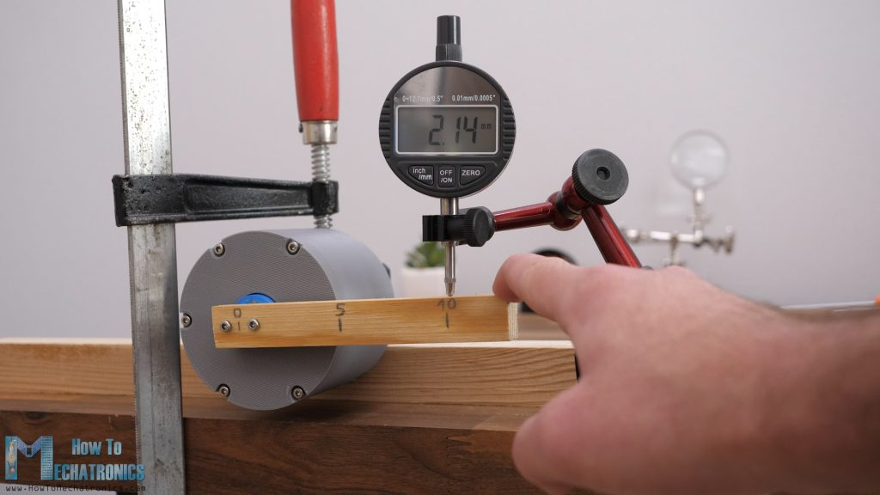
assets/raw/Backlash-testing-with-applied-force-1024x576.jpg
