jagathsrujan/3d-printable-planetary-gearbox/(commit log)

2026-09-22 Add two-stage 16:1 planetary gearbox STLs and build documentation
    Printable STL set for a 16:1 two-stage planetary gearbox for a NEMA 17
    stepper, printed in PLA. Two 4:1 planetary stages in series with the ring
    gear doubling as the housing.
    README documents the gear specifications (module 1.5, 15T sun / 15T planet
    / 45T ring, 3 planets per stage), the full bill of materials, assembly
    steps, and the measured backlash (~18 arcmin) and efficiency (~50%).
    M3 bolt lengths per joint were derived by measuring the STL meshes
    directly, since the source build notes do not specify them:
    - front cover -> housing: 6 x M3 x 12 mm socket head
    - back cover -> housing: 6 x M3 x 16 mm socket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
    [Back cover r1.stl, CUTOUT - Back cover.stl, CUTOUT - Front cover.stl, CUTOUT - Ring gear.stl, Carrier p1 - stage 1 - Output.stl, Carrier p1 - stage 1.stl, Carrier p1 - stage 2.stl, Carrier p2 - stage 2 - Output.stl]
2026-09-22 Add complete bill of materials
    Buy-list for printed parts, fasteners, bearings, pins/bushings and the motor
    drive. Fastener lengths were re-measured from the STL geometry (counterbore
    depths, clearance lengths, insert pockets) instead of being carried over from
    the source article, and the input coupling's cross-hole reads Ø4.0 (M4 grub).
2026-09-22 Add electronics brief for the motor drive
    Hand-off spec for whoever builds the electrical side: parts, mechanical
    interface, gearing constants (3200 steps per output revolution, 0.3 deg
    backlash, 0.25 Nm input), required firmware behaviour, acceptance tests and
    the limits this gearbox imposes.
2026-10-26 Add AS5600 encoder mount CAD and deck assets
    - FreeCAD models for the NEMA 17, AS5600 module, and PLA press-fit holder
    - STEP/STL exports plus print and assembly notes
    - Product brief and tutorial image assets for the deck
    [as5600_module_and_magnet.step, encoder_mount.FCStd, encoder_mount_assembly.step, encoder_mount_holder.step, encoder_mount_holder.stl, nema17_17he15_1504s.step]
